nht-cyb/reacted-wheel-pendulum/Report/Bao cao hoi nghi.docx

# BÁO cáo hội nghị mô hình hóa và điều khiển mô hình cubli 2d

## 1. Tổng quan.

Bài toán mô hình hóa toán học cho mô hình con lắc ngược dạng một mặt của CUBLI bằng phương pháp phân tích động lực học xem xét cả các lực ma sát cho mô hình. Mô hình robot trên sử dụng một bánh đà đồng thời với một khớp chủ động ở chân con lắc làm động lực để cân bằng con lắc. Bài toán xây dựng hệ thống điều khiển PID mô phỏng cho con lắc ngược bằng Matlab Simulink, các thông số điều khiển cho hệ điều khiển PID trên được tìm bằng thuật toán tối ưu ACO – thuật toán tối ưu đàn kiến. Xây dựng bài toán điều khiển để con lắc ngược đi đến vị trí cân bằng tại vị trí thẳng đứng trong thời gian ngắn nhất, và điều khiển con lắc di chuyển theo bất cứ quỹ đạo đầu vào mong muốn nào. Kết quả của bài toán mô phỏng này có thể làm cơ sở để xây dựng mô hình robot CUBLI 2D & 3D thực tế và xây dựng mô hình điều khiển động lực bằng bánh đà khác trong tương lai.

Keywords: inverted pendulum, Cubli 2D, reaction wheel, balance control, PID controller, ACO Algorithms.

## 2. Giới thiệu.

### 2.1. Tổng quan về mô hình robot

Mô hình robot sử dung trong bài báo đây được lấy cảm hứng từ khối hộp robot CUBLI là một dạng con lắc ngược trong không gian 3 chiều và là một mô hình được sử dụng làm nền tảng xây dựng các hệ thống điều khiển và kiểm thử sự hiệu quả của các thuật toán điều khiển tối ưu. Mô hình CUBLI được phát triển và công bố lần đầu tiên vào năm 2012 do các tiến sĩ của đại học ETHZ Zurich phát triển – Raphael D. Andrea và Mohamaelihh cùng các cộng sự.

Robot có dạng khối hộp lập phương có khả năng tự cân bằng trên các cạnh và trên đỉnh của nó nhờ vào việc điều khiển ba bánh đà lắp ở ba mặt của khối. Ngoài ra khối có thể bật lên từ trạng thái nghỉ nằm trên mặt bàn và thực hiện cân bằng khi có tác động của ngoại lực vào robot và có khả năng cân bằng khi thay đổi góc nghiêng của bề mặt nó đang được đặt trên.

Việc cân bằng con lắc được thực hiện nhờ vào lực quán tính tạo ra từ ba bánh đà, theo nguyên lý bảo toàn động lượng, ta cần thực hiện điều khiển động cơ của các bánh xe sao cho tổng hợp các lực quán tính tạo ra từ đây triệt tiêu được trọng lực tác dụng lên hệ robot và chống lại lực ma sát nghỉ khi robot thực hiện bật lên từ vị trí cân bằng.

### 2.2. Ứng dụng trong thực tiễn

Bài toán điều khiển CUBLI sử dụng bánh đà là một nền tảng để xây dựng và phát triển các hệ thống điều khiển khác nhau, phục vụ mục đích học tập và nghiên cứu mở rộng. Bài toán điều khiển cân bằng con lắc ngược là một bài toán căn bản trong lĩnh vực điều khiển, là môi trường để thực hiện thử nghiệm và kiểm thử thuật toán điều khiển và tối ưu, có khả năng phát triển sâu rộng.

Ngoài ra, khi ta xét đến phương thức điều khiển bánh đà và động cơ, bài toán điều khiển trên có thể được áp dụng trong việc điều khiển drone và lĩnh vực hàng không vũ trụ. Đã có một số mô hình vệ tinh và trạm vũ trụ cùng với kính thiên văn được nghiên cứu thiết kế chế tạo sử dụng bánh đà để điều khiển vị trí, khi muốn xoay vệ tinh hay kính thiên văn đi một góc nhỏ nhằm hướng ống kính đến một vị trí ngôi sao hoặc chòm sao nhất định trong không gian, việc này không thể sử dụng động cơ cỡ lớn của tên lửa mà cần sự tỉ mỉ chính xác tuyệt đối, và các nhà khoa học đã ứng dụng bánh đà vào đây để giải quyết bài toán điều khiển này, nguyên lý của nó tương tự với nguyên lý CUBLI và con quay hồi chuyển gyroscope nhưng áp dụng trong môi trường ngoài không gian và không trọng lực. Với khả năng ứng dụng cao, việc điều khiển độ lệch với động lực là lực quán tính từ bánh đà vẫn còn là một lĩnh vực kinh điển và được đầu tư nghiên cứu trong ngành hàng không vũ trụ.

### 2.3. Phân tích mô hình CUBLI 2D

Với bài báo của chúng tôi, đề hiểu sâu sắc hơn vào nguyên lý điều khiển và nhằm mục tiêu xây dựng một bài toán tiền đề cho việc xây dựng một mô hình CUBLI thực tế chính xác, bài toán của bài báo đơn giản hóa vấn đề điều khiển hệ thống phi tuyến và đi vào sâu hơn việc xây dựng hệ thống điều khiển con lắc trong không gian hai chiều khi xét đến một mặt của khối CUBLI, là nền tảng trước khi thực hiện giải quyết bài toán cân bằng con lắc trong không gian ba chiều. Bài toán của con lắc ngược của paper được xây dựng khi xem xét hai yếu tố phục vụ cân bằng và điều khiển con lắc khi sử dụng một bánh đà gắn ở trên thân con lắc và một khớp chủ động ở gốc con lắc. Hoạt động của con lắc sẽ phụ thuộc vào lực sinh ra khi điều khiển hai nhân tố này, nhằm mở rộng phạm vi ứng dụng của bài toán khi áp dụng vào xây dựng mô hình thực tế.

Động lực dịch chuyển của con lắc đến từ một bánh đà gắn ở chính giữa thân con lắc. Bánh đà là một vật nặng xoay tròn trong không gian, tạo ra một lực quán tính đến từ gia tốc xoay của con lắc. Nguyên lý cơ bản của bánh xe quán tính đến từ lực quán tính tạo ra từ bánh xe và định lý bảo toàn động lượng trong hệ kín. Trong không gian khi không có trọng lực và ma sát triệt tiêu lực quán tính, khi motor xoay, tàu vũ trị sẽ xoay theo chiều ngược lại. Khi sử dụng một bánh đà thì ta có thể tạo ra chuyển động cân bằng trên một trục trong không gian. Vì vậy, để điều khiển hành vi của con lắc, ta sẽ cần đến ba bánh đà để đáp ứng được chuyển động trong không gian ba chiều.

Mô hình robot trong bài toán gồm một mặt bên của khối lập phương cùng một bánh đà gắn ở chính giữa mặt con lắc và một khớp chủ động bên dưới gốc con lắc nhằm điều khiển con lắc ngược. Ta có thể phân tích hệ thống theo các trường hợp riêng khi điều khiển con lắc bằng lực quán tính tạo ra từ bánh đà, lực tạo ra từ khớp phía dưới chân con lắc, và khi kết hợp cả điều khiển hệ thống với cả hai trạng thái trên quan hệ tương tác với nhau cùng một lúc. Hệ con lắc ngược CUBLI là một hệ thống kín với động lượng được bảo toàn và sự cân bằng của con lắc ngược phụ thuộc vào sự thay đổi của mômen quán tính tạo ra khi điều khiển các động cơ. Các hệ thống điều khiển được xây dựng dựa trên hệ điều khiển PID hoặc hệ điều khiển LQR, tuy nhiên đây vẫn là một đề tài chưa có nhiều công bố và còn rất nhiều phương pháp để tiếp cận và giải quyết bài toán.

### 2.4. Mục tiêu của bài toán

Bài báo này tập trung vào việc xây dựng mô hình hóa toán học cho con lắc ngược trong không gian hai chiều CUBLI, sử dụng phương pháp phân tích động lực học và xây dựng phương trình Langrange – Euler cho hệ năng lượng động lượng bảo toàn, ta sẽ tính toán tổng động năng và tổng thế năng sinh ra từ hệ thống này. Và bài báo trên xây dựng mô hình điều khiển mô phỏng cho con lắc bằng hệ điều khiển PID với đầu vào là góc lệch của con lắc so với vị trí cân bằng. Các tham số của hệ thống điều khiển PID được tìm kiếm bằng thuật toán tối ưu đàn kiến để sai số của bộ điều khiển là nhỏ nhất. Kết quả nghiên cứu trên là tiền đề cho việc giải quyết mô hình con lắc trong không gian ba chiều.

## 3. Mô hình hóa toán học.

### 3.1. Gắn các trục tọa độ cho con lắc.

Xét mô hình một mặt Cubli như hình dưới đây – dạng con lắc ngượcc với thân con lắc là một mặt vuông kích thước 15x15cm gắn một bánh đà ở chính giữa và một động cơ ở khớp chủ động ở dưới chân con lắc.

Ta đặt các hệ tọa độ để xác định vị trí của con lắc như sau:

Hệ tọa độ cố định đặt tại vị trí cân bằng với trục x trùng với phương ngang của mặt đất và trục y vuông góc hướng lên biểu diễn vị trí cân bằng khi trục giữa của con lắc trùng khớp với trục y.

Hệ tọa độ địa phương đặt trục trùng với một trục chéo của con lắc, đi qua tâm con lắc và tâm xoay của khớp dưới. Góc biểu diễn góc lệch giữa vị trí cân bằng của con lắc với vị trí hiện tại của con lắc, nếu con lắc tiến về vị trí cân bằng của nó, góc sẽ tiến đến 0

Hệ tọa độ địa phương đặt gốc tại tâm xoay của bánh đà, với góc để xác định vị trí – tốc độ của bánh đà khi điều khiển con lắc.

Một số định nghĩa về các vector cần thiết xuất hiện trong bài toán là vector thể hiện vị trí con lắc , vector thể hiện vận tốc góc của hệ là , vector biểu diễn gia tốc góc của hệ

Chuyển động của hệ phụ thuộc vào lực tác dụng từ bánh xe quán tính và các động cơ. Ta xét trường hợp con lắc bật lên từ vị trí nghỉ đến vị trí cân bằng, vì vậy hai lực ma sát nghỉ của thân con lắc và bánh xe quán tính cũng được xét đến trong hệ, tương ứng với và .

### 3.2. Bảng thông số liên quan của con lắc

Ta xác định được vận tốc góc của con lắc và mối liện hệ giữa nó với vận tốc góc của nó với bánh xe quán tính. Ta có một số kí hiệu biểu diễn như bảng thông số sau:

Bảng 1. Bảng thông số con lắc ngược.

Kí hiệu | Giá trị | Đơn vị | Tên
| | | Góc lệch giữa thân con lắc và trục tọa độ cố định phương thẳng đứng biểu diễn vị trí cân bằng của con lắc.
| | | Góc lệch giữa bánh xe quán tính so với trục tọa độ cố định.
| | | Khối lượng của thân con lắc (bao gồm mặt cạnh, trục cố định và động cơ, không bao gồm bánh xe)
| | | Khối lượng của bánh đà (gồm bánh xe nhôm và vành cố định bánh xe, không bao gồm động cơ)
| | | Tổng khối lượng của cả hệ vật gồm thân con lắc và bánh đà (không bao gồm pin, mạch và đế cố định).
| | | Mô men quán tính của thân con lắc xung quanh điểm trọng tâm của toàn hệ con lắc.
| | | Mô men quán tính của bánh xe quán tính xung quanh trục xoay của bánh xe
| | | Mô men quán tính của toàn bộ hệ con lắc ngược.
| | | Khoảng cách xét từ trọng tâm của con lắc đến trục xoay dưới chân con lắc.
| | | Khoảng cách xét từ trục xoay của bánh xe quán tính đến trục xoay dưới chân con lắc.
| | | Hằng số ma sát nghỉ của thân con lắc.
| | | Hằng số ma sát nghỉ của bánh đà.
| | | Hằng số hoạt động của động cơ.

### 3.3. Phân tích các lực thành phần tác dụng lên con lắc.

Động năng của hệ con lắc ngược:

| (0)

Thế năng của hệ con lắc ngược:

| (1)

Phương trình Larange được định nghĩa như sau:

| (2)

Với torque là vector lực tổng hợp tác dụng lên hệ khi không xét đến thế năng của hệ, torque ở đây bao gôm lực tạo ra bởi các động cơ và lực ma sát nghỉ của hệ.

Phương trình động lực học được xác định dưới đây:

| (*3)
| (*4)
| (*5)
| (*4)
| (3) (4) =>
| (4)

Từ đây ta đã tìm được mô hình hóa toán học cho hệ thống con lắc ngược là phương trình biểu diễn động lực học sau:

| (*3)

Trong đó: là ma trận khối lượng

là ma trận Coriolis

là ma trận thế năng trọng trường

là véctơ lực/mô men suy rộng

Với:

| (6)

## 4. Xây dựng hệ điều khiển PID.

### 4.1. Hệ điều khiển PID.

Hệ thống điều khiển PID là một hệ thống điều khiển vòng kín có phản hồi được sử dụng rộng rãi. Bộ điều khiển PID nhận đầu vào là một tín hiệu, và nó liên tiếp tính toán để xét xem giá trị sai số là giá trị chênh lệch của tín hiệu đầu ra và giá trị đầu vào mong muốn – để thay đổi – cộng trừ một lượng nào đó vào giá trị tín hiệu điều khiển – để sao cho giá trị đầu ra sát với mong muốn nhất tương đương với sao cho sai số là nhỏ nhất. Bộ điều khiển PID thực hiện điều chỉnh giá trị điều khiển bằng ba đại lượng:

- P – tỉ lệ với độ lớn của giá trị sai số
- I – tỉ lệ với độ lớn tích phân hàm sai số trong một khoảng thời gian
- D – tỉ lệ với độ lớn của đạo hàm hàm sai số trong một khoảng thời gian

Phương trình của tín hiệu điều khiển cho bộ điều khiển PID được biểu diễn dưới đây:

| (7)

Trong đó: là tham số tỉ lệ

là khoảng thời gian thực hiện tích phân

là khoảng thời gian thực hiện đạo hàm.

Để tìm hàm truyền của hệ thống và ảnh hưởng các tham số điều khiển, ta thực hiện phép biến đổi Laplace cho phương trình trên ta được:

| (8)

Hàm truyền của hệ thống là:

| (9)
Với: | (10)

### 4.2. Xây dựng hệ điều khiển con lắc ngược

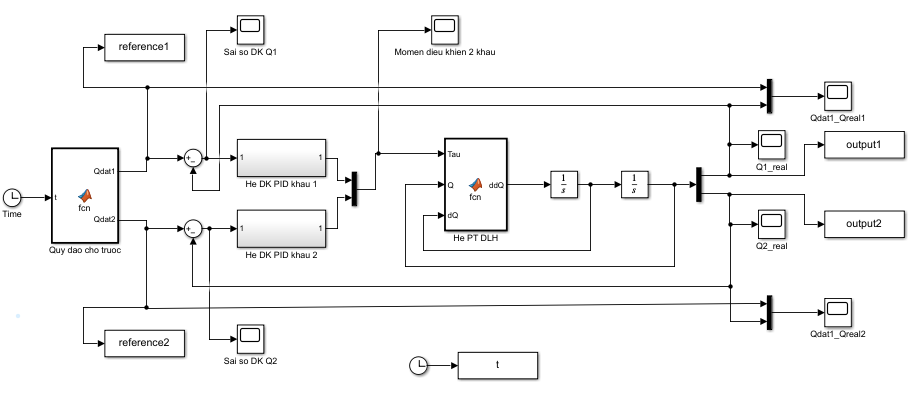
[picture p12: figure]

Hình 1. Sơ đồ simulink hệ thống điều khiển con lắc ngược.

Hệ thống điều khiển con lắc ngược nhận đầu vào là giá trị góc khớp mong muốn và khởi tạo một số tham số như giá trị vị trí ban đầu của con lắc, số vòng lặp thực hiện, khoảng thời gian xem xét, giới hạn sai số và từ đó, truyền vào bộ điều khiển PID và bộ phương trình động lực học của con lắc ngược ta đã tìm được từ mô hình hóa toán học phần trên, từ đó ta liên tục tính toán để được quá trình cần thiết để cân bằng con lắc.

Hệ thống xem xét giá trị sai số tính từ vị trí hiện tại của góc khớp thu được từ cảm biến góc với vị trí yêu cầu của con lắc – vị trí cân bằng tại hệ trục thẳng đứng, giá trị sai số này được truyền vào bộ điều khiển PID để tính toán sao độ dịch chuyển của con lắc sao cho sai số trở về giá trị nhỏ nhất, tiến đến không và con lắc trở về vị trí cân bằng.

Quá trình con lắc thực hiện cân bằng tính được dùng để khảo sát vận tốc xoay của góc khớp và mômen xoắn mà góc khớp tạo ra để đáp ứng cho việc cân bằng con lắc. Mục tiêu của quá trình cân bằng là có thể thực hiện điều khiển con lắc về vị trí thẳng đứng trong khoảng thời gian ngắn nhất và tạo ra ít dao động dư thừa nhất. Việc khảo sát mômen lực của động cơ có thể được áp dụng trong việc lựa chọn động cơ có đủ tải và công suất để xoay con lắc cân bằng từ vị trí nghỉ bật lên vị trí cân bằng. Quá trình trên cần sự tính toán kĩ lưỡng bởi yêu cầu một lực lớn để có thể bật con lắc lên và cần phải có một hệ điều khiển đáp ứng nhanh tránh việc con lắc đổ ật về phía trước khi đi qua vị trí cân bằng.

Các thông số cho bộ điều khiển PID được truyền vào bộ điều khiển từ bước tính toán trong thuật toán tối ưu đàn kiến. Phần trình bày bài toán của thuật toán tối ưu đàn kiến sẽ được trình bày chi tiết hơn ở phần sau.

## 5. Áp dụng thuật toán ACO.

### 5.1. Thuật toán ACO.

Thuật toán đàn kiến là một thuật toán tối ưu dựa vào sự lựa chọn xác suất của nhiều search agents. Thuật toán đàn kiến lấy ý tưởng từ hoạt động của đàn kiến trong quá trình giao tiếp với nhau và tìm kiếm nguồn thức ăn, chúng sử dụng pheromones để thực hiện ghi lại dấu vết trên đường đi của chúng như một cách đánh dấu để tìm đường về tổ của mình, cũng như một cách để thông báo cho các thành viên khác trong đàn dấu vết của mình để các con kiến khác đi theo đến nguồn thức ăn theo nó. Pheromone của loài kiến là một hợp chất hóa học đặc trưng có khả năng bay hơi theo thời gian, kiến thường có xu hướng chọn con đường nào có nhiều lượng pheromones hơn để đi khi thám thính môi trường và phát hiện con đường mới để dẫn đến nguồn thức ăn.

### 5.2. Nội dung thuật toán

Giả sử khi có n nguồn thức ăn khác nhau từ tổ kiến với tương ứng n con đường đi từ tổ, tốc độ của các con kiến và tốc độ bay hơi của pheromones là giống nhau giữa tất cả các con kiến, khi bắt đầu đi tìm mồi, trong môi trường không có dấu vết của pheromones để quá trình di chuyển đến các nguồn thức ăn là ngẫu nhiên. Khi con đường dẫn đến nguồn thức ăn ngắn hơn, lượng pheromone bay hơi đi ít hơn, con kiến lấy được thức ăn và bò về tổ, lượng pheromones trên con đường đó được cộng hem một lượng nữa. Ngược lại với đường dài sẽ có ít pheromone lưu lại trên con đường ấy hơn. Vì vậy trong lần tiếp theo, xác suất kiến đi vào những con đường ngắn hơn sẽ cao hơn bởi có nhiều lượng pheromone còn lưu lại trên con đường này hơn.

Công thức của xác suất mà đàn kiến lựa chọn được biểu diễn dưới đây:

| (11)

Với là xác xuất con kiến sẽ chọn đi con đường từ x đến y này.

là nồng độ pheromones lưu lại trên con đường xét

là đại lượng cố định biểu diễn độ hấp dẫn của nguồn thức ăn trên con đường đó, được khởi tạo từ bước ban đầu.

Sau nhiều vòng lặp, con đường dài đến thức ăn sẽ hầu như bay hơi hết pheromone bởi không có nhiều xác suất được lựa chọn để đi, và con đường ngắn thì sẽ rõ ràng hơn khi xác suất được chọn của nó cao hơn theo mỗi lần vì có sự cộng thêm phe mỗi lần chúng đi vào đây. Công thức biểu diễn sự biến đổi của xác xuất có thể được thể hiện dưới đây:

| (12)

Với là lượng pheromones trên quãng đường thứ k từ x đến y. Sau mỗi vòng lặp lượng pheromones giảm đi một ít theo tốc độ bay hơi , và được cộng thêm một lượng là tổng các lượng pheromones của các con kiến di chuyển trên quãng đường này trong lần lặp đó để lại, với độ tăng thêm pheromones của mỗi con kiến được tính ở công thức phía dưới. Khi đàn kiến đã chọn con đường nào để đi thì lượng pheromones trên đó tăng lên, còn trên các con đường khác không tăng mà giảm dần theo thời gian.

Lưu đồ thực hiện của thuật toán tối ưu đàn kiến được trình bày như sau:

Quá trình thực hiện thuật toán tối ưu đàn kiến ACO:

Khởi tạo các giá trị cần thiết ban đầu;

Thực hiện vòng lặp:

Khởi tạo giá trị đàn kiến;

Tính toán giá trị so sánh xem xét tối ưu cho hàm điều kiện
với mỗi con kiến;

Tìm phương án tối ưu nhất qua phương pháp lựa chọn
và xác suất thể hiện;

Cập nhật pheromones cho các kết quả;

Kết thúc vòng lặp

Kết thúc quá trình.

## 5.3. Áp dụng thuật toán vào hệ điều khiển

Ta sử dụng toolbox được xây dựng sẵn về quá trình tính toán tối ưu của thuật toán tối ưu đàn kiến trên Matlab để thực hiện quá trình. Sau đó ta trích dẫn một giá trị sai số references từ hệ simulink xây dựng cho hệ thống điều khiển ở trên và truyền vào hàm tính toán đặc trưng mới cho bài toán điều khiển con lắc ngược. Hàm tính toán đặc trưng này được viết lại mới để thay vào và tìm giá trị bộ tham số PID nào phù hợp thỏa mãn đưa hệ về cân bằng tối ưu nhất sau n vòng lặp thực hiện ta khởi tạo từ đầu. Phần gán tham số phù hợp với thuật toán đàn kiến sẽ được trình bày như sau:

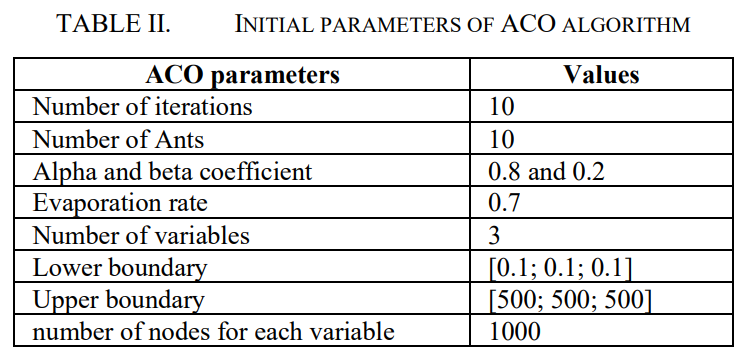
[picture p13: figure]

Bảng 2 . Các thông số khởi tạo ban đầu cho thuật toán tối ưu.

Trước tiên ta khởi tạo đàn kiến gồm có n phần tử tìm kiếm, thực hiện i vòng lặp đi từ tổ đến nguồn thức ăn, ta khởi tạo trên địa bàn giới hạn sẽ có m nguồn thức ăn và khởi tạo độ hấp dẫn của nguồn thức ăn đó từ đầu cố định, lượng pheromones trên mỗi con đường tại thời điểm xuất phát là đều bằng 0 đảm bảo tính công bằng khi xét xác suất. Từ vị trí và đặc trưng của mỗi nguồn thức ăn – tương đương với mỗi bộ thông số điều khiến PID ta khởi tạo để xét tính tối ưu – ta truyền chúng vào một hàm tính giá trị đặc trưng sử dụng tính độ lớn của sai số khi sử dụng các bộ PID này một lượt, bộ nào cho ra giá trị nhỏ nhất thì sẽ được đàn kiến chọn đi và cộng dồn xác suất. Sau một khoảng thời gian tính toán và so sánh tất cả các giá trị sai số tương ứng với các bộ PID, ta chọn ra một bộ PID thỏa mãn cho sai số nhỏ nhất và quãng thời gian tiến về cân bằng ngắn nhất và trả ra kết quả. Từ bộ PID ta tìm được, truyền vào hệ simulink điều khiển trên ta sẽ tính được quá trình cân bằng của con lắc ngược và biểu diễn được trên các đồ thị về sai số vị trí, thời gian cân bằng, vận tốc xoay và lực tác dụng của động cơ.

## 6. Kết quả - đánh giá.

Đầu vào của bài toán điều khiển con lắc ngược đến vị trí cân bằng, giá trị góc lệch con lắc bằng 0(rad).

Hàm độ lớn sai số để xác định phương án tối ưu:

Kết quả bộ PID tìm được sau khi sử dụng thuật toán tối ưu được biểu diễn dưới đây:

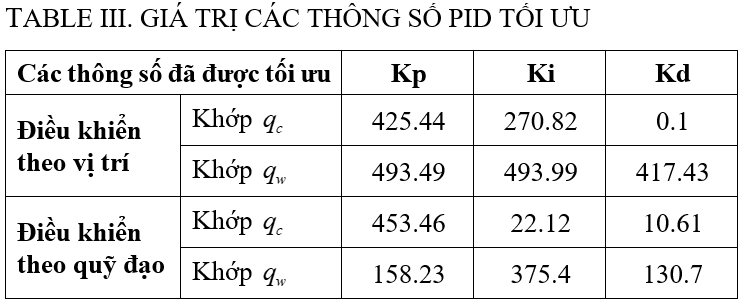
[picture p14: figure]

Bảng 3 . Bảng các bộ thông số PID tối ưu tìm được.


Hình 2. Giá trị sai số điều khiển của con lắc.


Hình 3. Giá trị góc lệch xét tại thân con lắc với vị trí cân bằng.


Hình 4 . Giá trị góc lệch xét góc giữa bánh đà và hệ trục trên con lắc.

- Con lắc đặt vị trí cân bằng tại thời điểm 4.5(s) sau khi bắt đầu.
- Giá trị độ vọt lố tối đa lần lượt là 0.04(rad) và 0.02(rad) tại hai quá trình điều khiển.
- Thời gian con lắc dịch chuyển để đạt đến gần vị trí cân bằng rất nhỏ 0.5(s).
- Sai số trạng thái ổn định của hệ thống đạt được giá trị mong muốn về 0 sau 6(s).

Đầu vào của bài toán điều khiển con lắc ngược di chuyển theo một quỹ đạo nhất định:


Hình 5. Giá trị góc xoay khi điều khiển quỹ đạo.

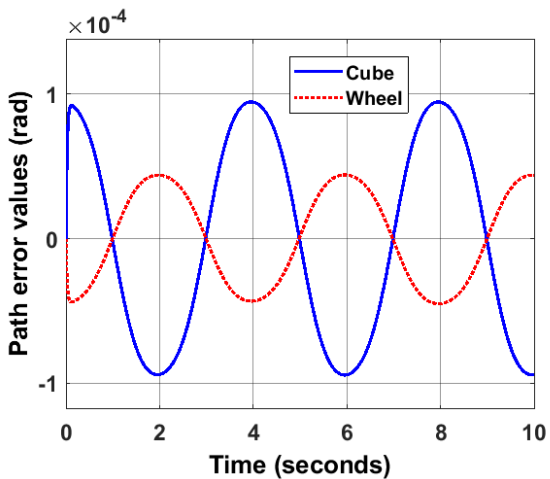
[picture p15: figure]

Hình 6. Giá trị sai số góc xoay khi điều khiển quỹ đạo.

- Kết quả ở đồ thị cho thấy hệ thống điều khiển con lắc bằng quỹ đạo cho một sai số rất nhỏ.

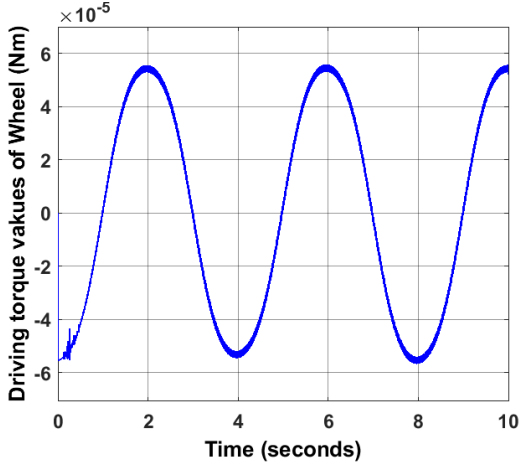
[picture p16: figure]
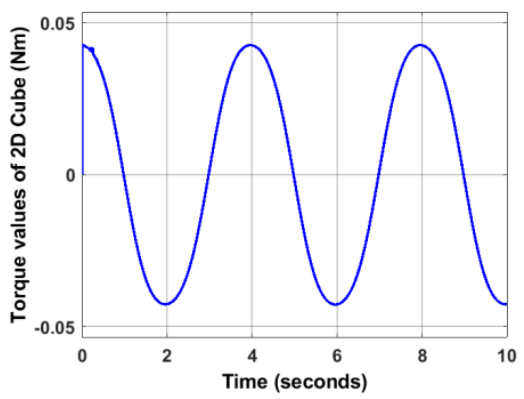
[picture p17: figure]

- Sai số lớn nhất khi điều khiển quỹ đạo con lắc là với giá trị vị trí thân con lắc, và với sai số góc quay bánh đà là

Hình 7. Giá trị momen lực của con lắc khi
điều khiển với quỹ đạo cho trước.

- Kết quả ở đồ thị cho thấy mô phỏng giá trị của lực tác dụng lên hệ thống con lắc trong quá trình điều khiển bằng quỹ đạo.
- Vì quỹ đạo của con lắc có quy luật nên lực tác dụng để điều khiển con lắc cũng biến đổi theo quy luật nhất định.
- Kết quả sau để khảo sát lực tạo ra bởi động cơ và để làm cơ sở chọn động cơ phù hợp khi làm thực tế.

## 7. Tổng kết.

Bài báo trên diễn tả quá trình xây dựng bài toán điều khiển mô phỏng cho con lắc ngược CUBLI trong không gian hai chiều, từ việc mô hình hóa toán học bằng phương pháp Lagrange kết hợp với việc phân tích tổng hợp lực, tổng năng lượng cho hệ với động lượng bảo toàn, mối quan hệ của lực quán tính tạo ra bởi bánh đà trên con lắc với hệ thống và vị trí của con lắc khi chịu tác động của trọng lực và ma sát.

Xây dựng hệ thống điều khiển con lắc ngược sử dụng bộ điều khiển PID với các thông số điều khiển được lựa chọn bằng thuật toán ACO để cho được kết quả với sai số nhỏ nhất. Bài toán điểu khiển con lắc di chuyển đến vị trí cân bằng và duy trì trạng thái thẳng đứng, trường hợp thứ hai khi điều khiển con lắc di chuyển theo một quỹ đạo bất kì ta quy định ban đầu.

Hiệu quả của việc sử dụng thuật toán tối ưu được ghi lại và so sánh với đầu vào quy định trước. Kết quả của bài toán có thể được phục vụ để xây dựng và phát triển hệ thống điều khiển phi tuyến và phục vụ mục đích xây dựng mô hình 3D và các hệ thống điều khiển hiện đại khác.

# tài liệu tham khảo

[1] P. Reist and R. Tedrake, “Simulation-based lqr-trees with input and state constraints,” in Robotics and Automation (ICRA), 2010 IEEE International Conference on, may 2010, pp. 5504 – 5510.

[2] R. L. Mark, W. Spong, P. Corke. Nonlinear control of the inertia wheel pendulum. Automatica, 1999.

[3] https://idsc.ethz.ch/research-dandrea/researchprojects/archive/cubli.html

[4] M. Gajamohan, M. Merz, I. Thommen, R. D’Andrea. The Cubli: A Cube that can Jump Up and Balance. 2012 IEEE/RSJ International Conference on Intelligent Robots and Systems, 2012. Vilamoura, Algarve, Portugal.

[5] A. Nalin, D. D. Bernstein, H. McClamroch, J. Shen, A. K. Sanyal. Dynamics and control of a 3d pendulum. In 43rd IEEE Conference on Decision and Control, pages 323–328, University of Michigan, December 2004.

[6] T. Widmer, M. Gajamohan, M. Muehlebach, R. D’Andrea. The cubli: A reaction wheel-based 3d inverted pendulum. In 2013 European Control Conference, pages 268–274, Switzerland, July 2013.

[7] K. G. John, W. Romanishin, R. Daniela. M-blocks: Momentumdriven, magnetic modular robots. IROS, 2013.

[8] H. K. Khalil, Nonlinear Systems, Pearson India; 3th edition (2014)

[9] J. Meyer, N. Delson, and R. de Callafon, “Design, modeling and stabilization of a moment exchange based inverted pendulum,” in 15h IFAC Symposium on System Identification, Saint-Malo, France, 2009, pp. 462 – 467.

[10] S. L. Elena. Cubic Structure Capable of Balancing. Bachelor’s Thesis. University POLITEHNICA of Bucharest. 2015.

[11] D. Posada. Design and control of an inertia wheel cube 2D prototype with a reaction wheel. Bachelor of Science in Mechanical Engineering. Universidad De Los Andes. 2017.

[12] B. Andrievsky, “Global stabilization of the unstable reactionwheel pendulum,” Automation and Remote Control, vol. 72, pp. 1981–1993, 2011.

[13] D. Morin. Introduction to classical mechanics with problems and solutions. Cambridge University Press, 2008.

[14] K. Astrom and T. Hagglund. PID Controllers: Theory, Design and Tuning. Instrument Society of America, USA, 1995.

[15] M. Dorigo, V. Maniezzo, A. Colorni (1991) The ant system: an autocatalytic optimizing process, Technical Report TR91-016, Politecnico di Milano.
