nht-cyb/reacted-wheel-pendulum/(commit log)

2026-10-05 Restructure project: shared PID-tuning files, system model, firmware
    - Move the Simulink plant models and cost functions shared by both
    optimisers into pid-tuning/common (position = Vitri, trajectory = Quydao)
    - Merge the duplicated initialization.m / parameter.m into one copy and fix
    the function name in initialization.m
    - Move 1-axis-pendulum to system-model and fix pendulum.m (missing '*' in
    the A matrix, double D matrix)
    - Turn the Arduino .txt files into firmware/ sketches
    - Keep the original .rar backups in archive/
    - Add comments to all files and a .gitignore for Simulink build files
    [KalmanFilterMPU.ino, MotorControlArduino.ino]
2026-10-05 GWO: add commented Grey Wolf Optimizer PID tuning scripts
    - runGWO_Vitri.m (position control) and runGWO_Quydao.m (trajectory
    tracking) now load the shared model and cost function from
    pid-tuning/common
    - Fix the position update: Positions(j) -> Positions(i,j). The old linear
    index only updated the first column, so the pack barely moved and the
    search was close to random
    - Add the GWO simulation result plots from the report (media/results)
2026-10-05 ACO: add Ant Colony Optimization (ACO_R) PID tuning scripts
    - runACO_Vitri.m (position control) and runACO_Quydao.m (trajectory
    tracking) implement ACO for continuous domains (Socha & Dorigo, 2008):
    a sorted solution archive acts as the pheromone, each ant samples the
    gains from a Gaussian around a rank-selected guide solution
    - Same gains, bounds, cost function and simulation budget as the GWO
    scripts so both optimisers can be compared directly
    - Add the ACO simulation result plots from the report (media/results)
2026-10-05 Report: add project report and schematic
    Keep third-party papers (References/) and downloaded code
    (Report/New folder/) out of the repository via .gitignore.
